anumby-source/RobotServiceJeunesse2022/README.md

# RobotServiceJeunesse2022

Construisez votre voiture robot ! A partir d'un [kit de montage](https://github.com/anumby-source/RobotServiceJeunesse2022/wiki), vous assemblez une voiture intelligente

Vous construisez une voiture-robot avec des cellules solaires ou un détecteur à ultrason. Nous vous aidons à réaliser vos projets

voiture avec guidage par ultrason

[ultrason pour le châssis voiture](
https://user-images.githubusercontent.com/90700891/155990377-5c4f1362-04a4-40f6-9944-eb9b7a41df36.mp4 "ultrason pour le châssis voiture")

voiture avec 2 cellules orientées vers la route ou vers l'avant pour suivre un rayon de soleil

voiturevoiture

Nous avons aussi un peu de travail de bois

bois

Voir le projet complet sur [developpement-voiture](https://github.com/anumby-source/developpement-voiture/wiki)
