anumby-source/RobotServiceJeunesse2022/code/README.md

- [installation de MicroPython sur ESPxxx](https://www.aranacorp.com/fr/programmez-un-esp8266-avec-micropython/)
- [MicroPython for ESP8266 Reference](https://docs.micropython.org/en/latest/esp32/quickref.html)
- [Web server pour ESP8266 en MicroPython](https://randomnerdtutorials.com/esp32-esp8266-micropython-web-server/)



- [micropython async tuto](https://github.com/peterhinch/micropython-async/blob/master/v3/docs/TUTORIAL.md)

- https://micropython.org/download/esp8266/
- https://github.com/anumby-source/developpement-voiture/wiki/d%C3%A9veloppement-IA-en-python#wiki-pages-box
- https://docs.micropython.org/en/latest/esp8266/quickref.html#networking
- https://circuits4you.com/2017/12/21/esp8266-pwm-example/
- https://randomnerdtutorials.com/esp8266-pinout-reference-gpios/

https://dl.espressif.com/dl/package_esp32_index.json,http://arduino.esp8266.com/stable/package_esp8266com_index.json

echo D6
trigger D7
capteur optique:
A0
équilibre 3.3v/2.
