anumby-source/RobotServiceJeunesse2022/Détecteur de collisions/neo/READ-ME.md

capteur ultrason avec LED multicolore

Le capteur ultrason va allumer une led multicolore

- Rouge si distance < 10 cm
- Verte  si distance > 40 cm
- la couleur va changer du jaune, blanc au bleu pour les positions intermédiaires

Pour cela, la PIN D-IN de la LED est placée sur l'entrée TRIGGER du capteur ultrason

L'écriture de la LED est effectuée une fois la lecture du capteur ultrason. Un délai est ajouté pour tenir compte de la distance maximale de détection
