anumby-source/RobotServiceJeunesse2022/MotorShield.docx

MotorShield

Technical specs

https://cdn.hackaday.io/files/8856378895104/user-mannual-for-esp-12e-motor-shield.pdf

Schema

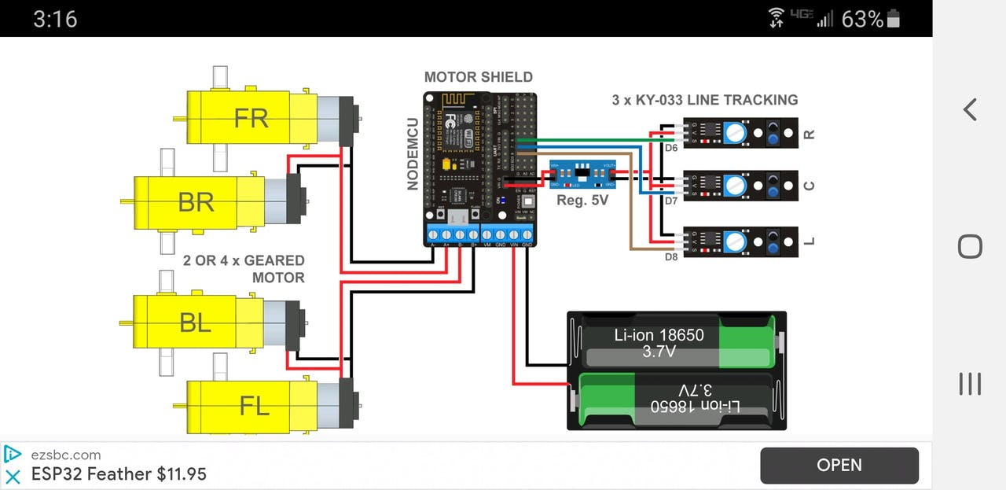
[picture p1: figure]
What Do I Build Next? ESP8266MOD WiFi car - Hackster.io
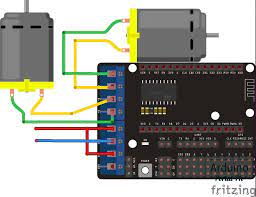
[picture p2: figure]
NodeMcu Motor Shield. Описание и тестовый Скетч
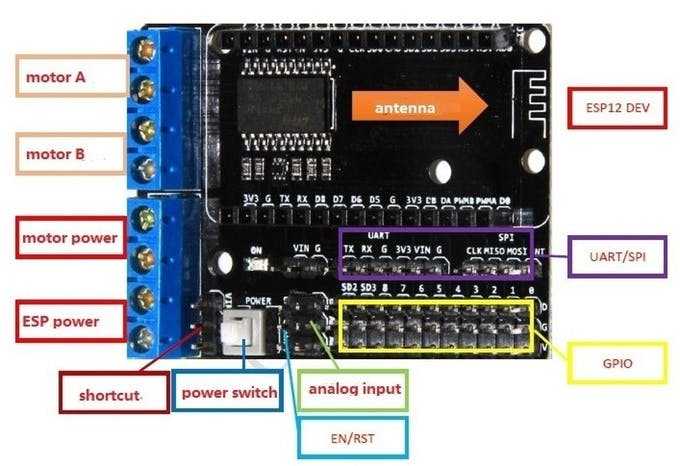
[picture p3: figure]
ESP Motorshield
