anumby-source/RobotServiceJeunesse2022/code/robot/doc.pptx

## Code pour le robot

Robot.ino

## Slide 2

Motorisation

Moteur
droit

D1

D3

Moteur
gauche

D2

D4

PWM

Motorisation

Stop()
Avance()
Recule()
Droite()
Gauche()
Action(commande)

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
Direction
DROIT
DROITE
GAUCHE

Commande D/G ()
Vitesse, Sens

Action(commande)

Boîte de Vitesse()

Sens
STOP
AVANCE
RECULE

## Slide 3

Ultrason

Lecture()

obstacle

AVANCE

< seuil2

DROIT

0

RECULE

< seuil1

direction

Avance()

GAUCHE

DROITE

M.gauche()

Choix Random()

GAUCHE

M.gauche()

DROITE

M.droite()

M.droite()

commande

Motorisation

Action(commande)

> seuil1

Ultrason

D7

D6

Trigger

echo

UltraSon

Lecture()
Action(commande)

seuil1
seuil2

légende

Si…

retour

variable

## Slide 4

Web

handle_args()

O.action(commande)

Web_Suivi

Pager()

server.argName

server.args()

Web

Init()
Header()
Trailer()
virtual Pager()
Int id

Web_Motorisation

Pager()

comande = server.arg

COMMANDE

MANUEL

COLLISION

EQUILIBRAGE

Web_Collision

Pager()

M.action(commande)

WM.pager()

SUIVI

Web_Equilibrage

Pager()

U.action(commande)

WC.pager()

légende

Si…

retour

variable

WS.pager()

WB.pager()

O.equilibrage(commande)
