anumby-source/RobotServiceJeunesse2022/Base/README.md

Documents pour la base
=======================
