anumby-source/RobotServiceJeunesse2022/Détecteur de collisions/README.md

Documents pour le détecteur de collisions
=========================================
