anumby-source/RobotServiceJeunesse2022/Plan d'actions.md

Préparation du [projet "Robot Service Jeunesse"](https://github.com/anumby-source/RobotServiceJeunesse2022/blob/main/Administration/2022%2003%2009%20Service%20Jeunesse%20V%C3%A9hicule%20WIFI%20pilot%C3%A9%20par%20s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) en prévision de la journée du 6 mai 2022
=======================================================================================

- Les documents du projet précédent 2019 ont été récupérés et instalés dans le dossier [Documents 2019](https://github.com/anumby-source/RobotServiceJeunesse2022/tree/main/Documents%202019)
- vérifier la liste des composants 
    -	Une boîte en plastique
    -	Socle
    -	2 roues
    -	Esp + barrettes 
    -	Shield
    -	Entretoises
    -	piles
    -	Sachet avec 
        -	le support pour les piles
        -	les moteurs
        -	la roulette avant
        -	visserie
- vérifier le mode opératoire
- le mardi 15 mars on réalise un montage de test pour vérifier
    - les éléments
    - le mode opératoire
    - le plan de cablage 
- quelques notes:
    - enlever la pellicule de protection
    - ajuster les trous sur la plaquette et ajouter les entretoises pour écarter le shield
    - comprendre le programme -> produire l’organigramme
    - préparer des options pour ajouter des capteurs
        - suiveurs de ligne
        - détection des obstacles (ultrason)
    - téléverser les programmes dans les esp

Principes de fonctionnement pour le projet:
===========================================

A priori tout ce que l'on prépare (le robot, sa base et ses options ultérieures) ont vocation à être réalisées par des jeunes du ServiceJeunesse, soit lors de la journée du 6 mai 2022, ou bien ultérieurement lors de futures sessions accompagnées par Anumby. Donc l'idée est que tout ce que l'on propose doit être "faisable", c'est à dire:
- documenté
- associé - sous forme de document ou d'un lien - à:
    - la liste des composants nécessaires 
    - le mode opératoire
    - les programmes à flasher
    - les plans de câblage
 - si ces éléments ne sont pas disponible, ceci doit être consigné dans une "action" (autrement dit une "issue") qui sera fermée lorsque l'element sera fourni
