anumby-source/RobotServiceJeunesse2022/Documents 2019/Tutoriel Véhicule WIFI piloté par smartphone V2.odp

## Tutoriel Mini véhicule WIFI piloté par smartphone

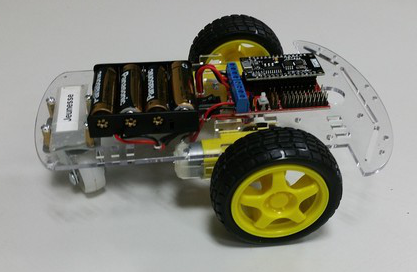
[picture p25: figure]

Sommaire

  Liste des pièces détachées
1. Fixation de la roue arrière pivotante
2. Montage moteurs
3. Montage roues motrices
4. Montage boîtier de piles
5. Montage shield moteur
6. Branchement boîtier de piles
7. Branchement moteurs droit et gauche
8. Fixation du microcontroleur
1. Insertion des piles et mise en service
1. Recherche du réseau WIFI du vhicule
2. Entrée du mot de passe
3. Lancer le navigateur de son smartphone
4. Saisie de l’adresse IP

Matériel prêté par l’Anumby

- Tournevis
- Pince
- Huile (pour la roue pivotante)

Apporter son smartphone

## Pièces détachées

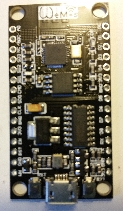
[picture p26: figure]

Le coeur du véhicule.

Programme et serveur WIFI

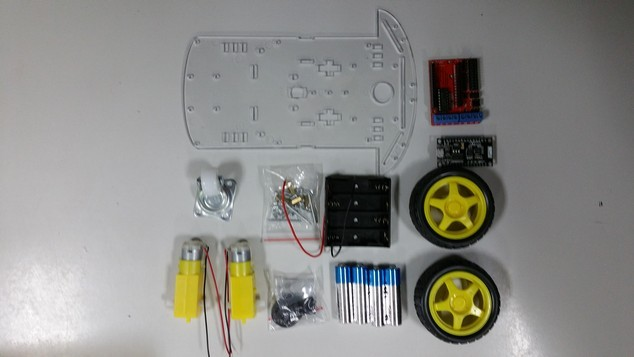
[picture p27: figure]

Châssis

ESP 8266 12 E

Roue arrière pivotante

Shield moteur

2 moteurs, (fils soudés)

Vis,

entretoises

4 piles AA

Porte piles

2 Roues motrices

## Fixation de la roue avant pivotante

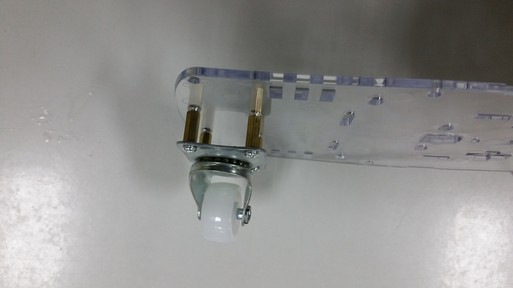
[picture p28: figure]
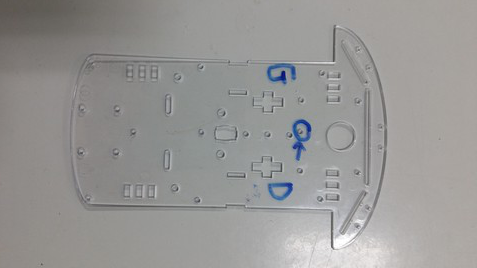
[picture p29: figure]
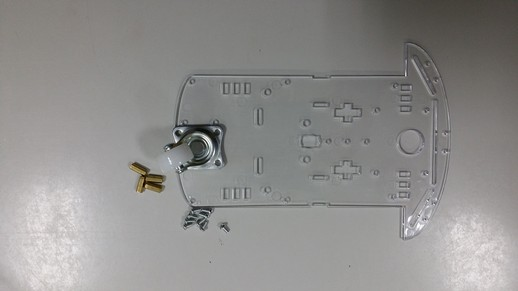
[picture p30: figure]

4 Entretoises

8 Vis

Roulette pivotante

Attention !

Placer la roue pivotante sous le châssis avec un trou décalé vers le coté gauche du châssis.

## 2) Montage des moteurs

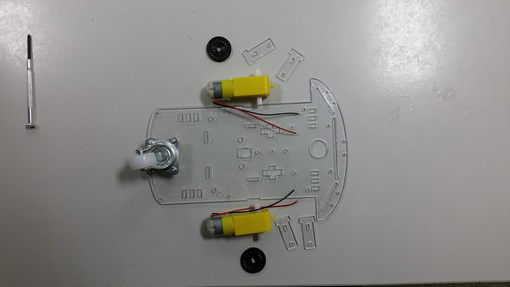
[picture p31: figure]
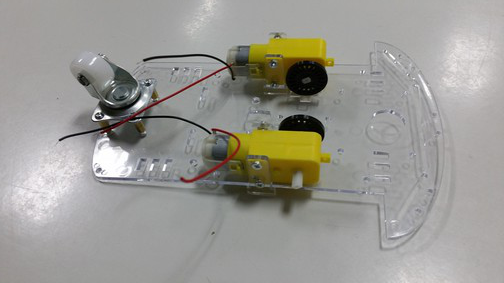
[picture p32: figure]
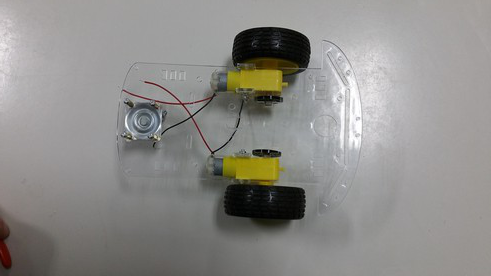
[picture p33: figure]
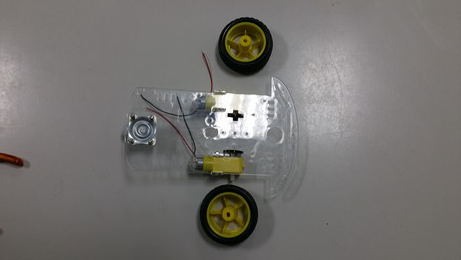
[picture p34: figure]

3) Montage des roues motrices

## 4) Montage boîtier de piles

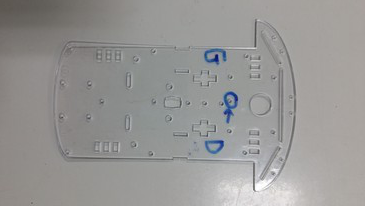
[picture p35: figure]
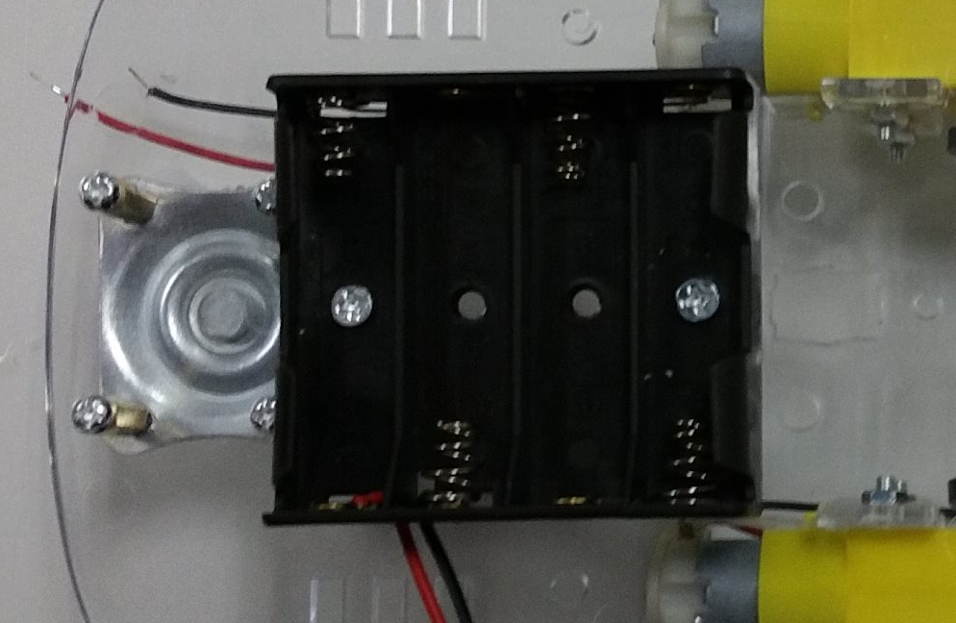
[picture p36: figure]

2 vis et écrous

5) Montage du shield (extension en français) moteur (électronique de commande des moteurs et pont en H permettant l’inversion de sens de rotation des moteurs)

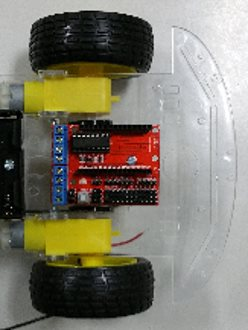
[picture p37: figure]

1 vis + écrou + entretoise

Arrière du véhicule

Avant du véhicule

Rappel !

Vérifier que, vu de dessus, le trou décalé du châssis se situe vers le moteur gauche !

Moteur Gauche

## 6) Branchement du boîtier de piles

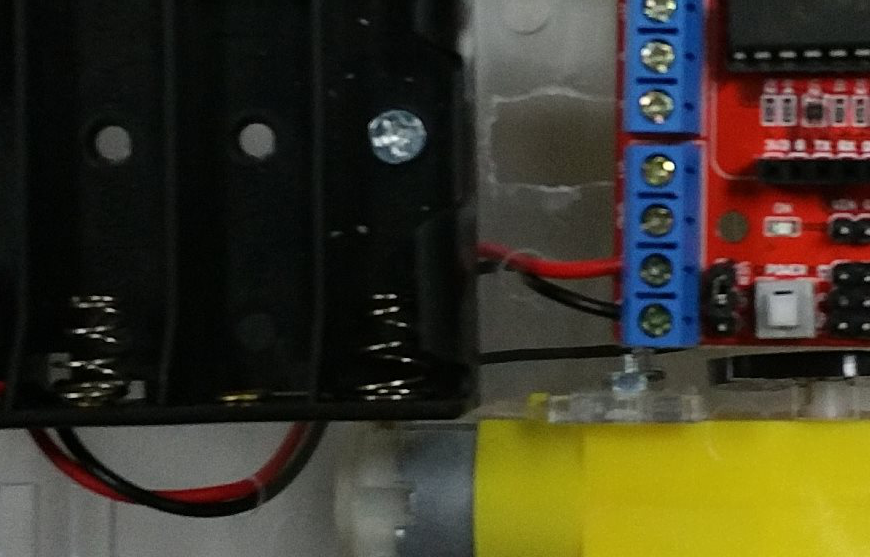
[picture p38: figure]

Branchement du câble + et du fil - sur le bornier

7) Branchement moteurs gauche et droite

Moteur gauche

câbles + et – sur le bornier (partie gauche)

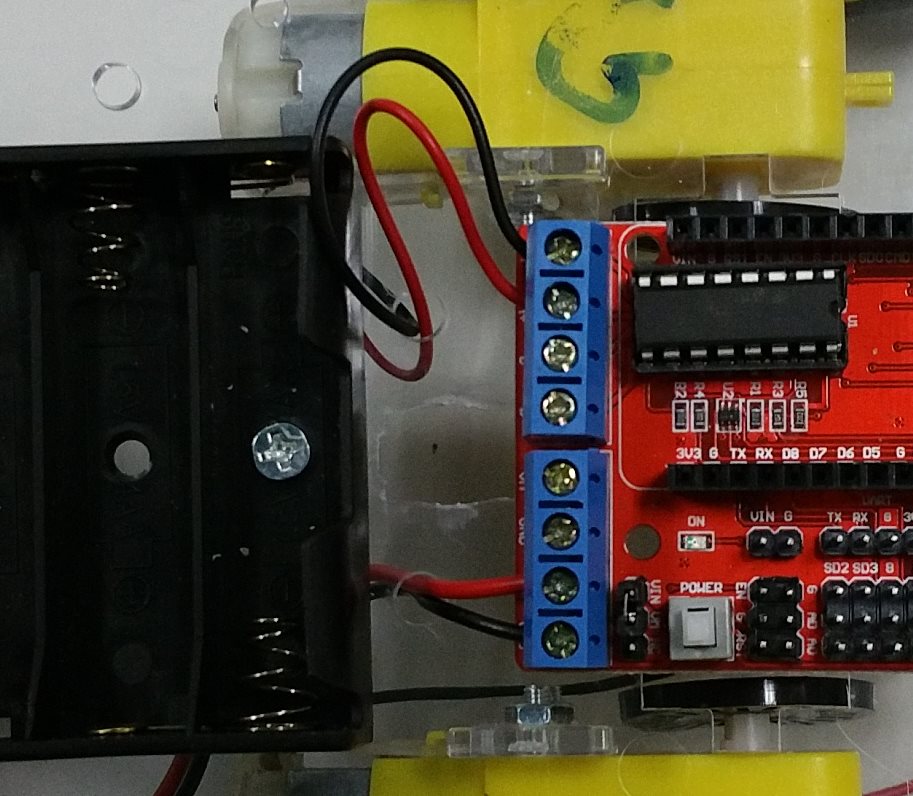
[picture p39: figure]

Moteur droite

Câbles + et – sur le bornier (partie droite)

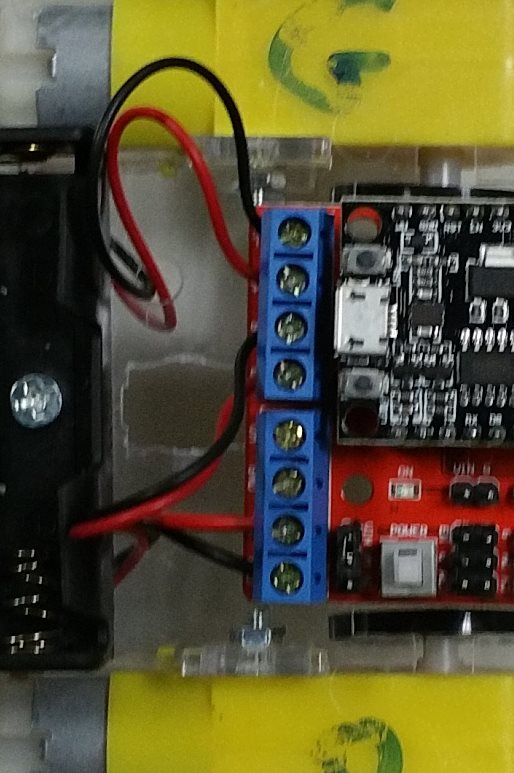
[picture p40: figure]

## 8) Fixation du microcontroleur ESP 8266 sur le shield moteur

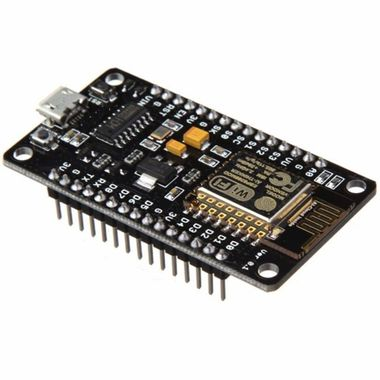
[picture p41: figure]

Antenne WIFI

Attention au sens du montage !

Antenne WIFI de l’ESP 8266 vers l’arrière du véhicule

Arrière du véhicule

## 9) Insertion des piles et mise en service

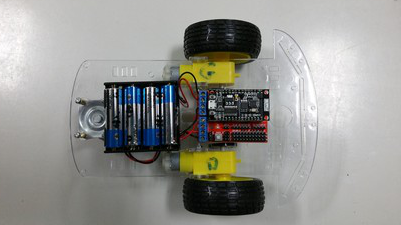
[picture p42: figure]
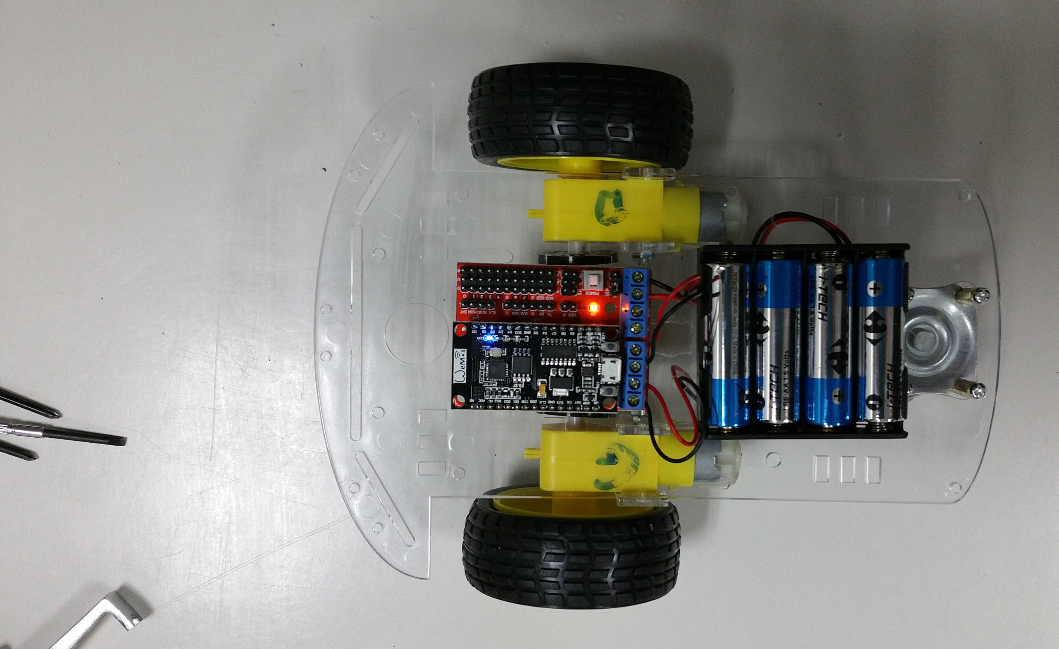
[picture p43: figure]

Vérifier le sens des piles !

Appuyer sur l’interrupteur du shield

Une led rouge s’allume

Le véhicule est prêt à être piloté !

## 10) Recherche du réseau WIFI de votre véhicule

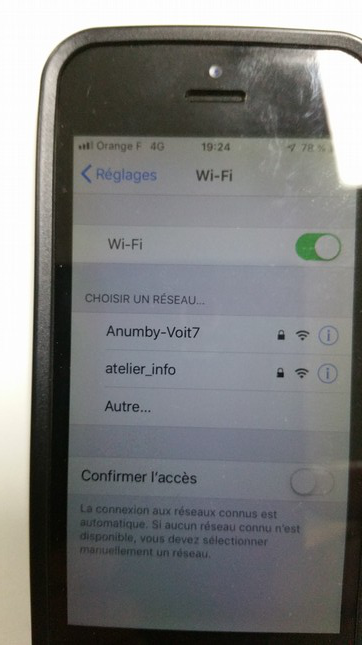
[picture p44: figure]

Avec la plupart des smartphones

1. Paramètres/
2. Connexion réseau/
3. WIFI/
4. Chercher le réseau Anumby-Voiture- -
5. Taper sur connexion

11) Taper le mot de passe : 12345678

## 12) Lancer le navigateur de son smartphone

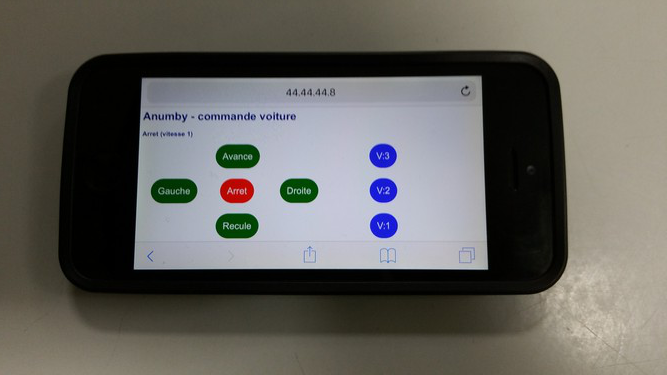
[picture p45: figure]

13) Taper l’adresse IP : 44.44.44.1 à 6

(Chaque véhicule est numéroté de 1 à 6)

Puis Piloter son véhicule
