anumby-source/RobotServiceJeunesse2022/Documents 2019/Organigramme Programme Voiture.pdf

# ANUMBY Organigramme Programme Voiture

## 8 Mars 2019

# Programme Principal

Inclusion librairies:
- WiFi
- WebServer
- Mise à jour à distance

Définition Variables:
- Nom WiFi
- Mot de passe
- Adresse IP
- Vitesses moteurs

Setup – Initialisations:
WiFi
Fonctions mise à jour
Commandes voitures
Erreur affichage Page Web

Loop:
Action si mise à jour
programme demandée à
distance
Affichage Page Web

# Programme dans la Loop

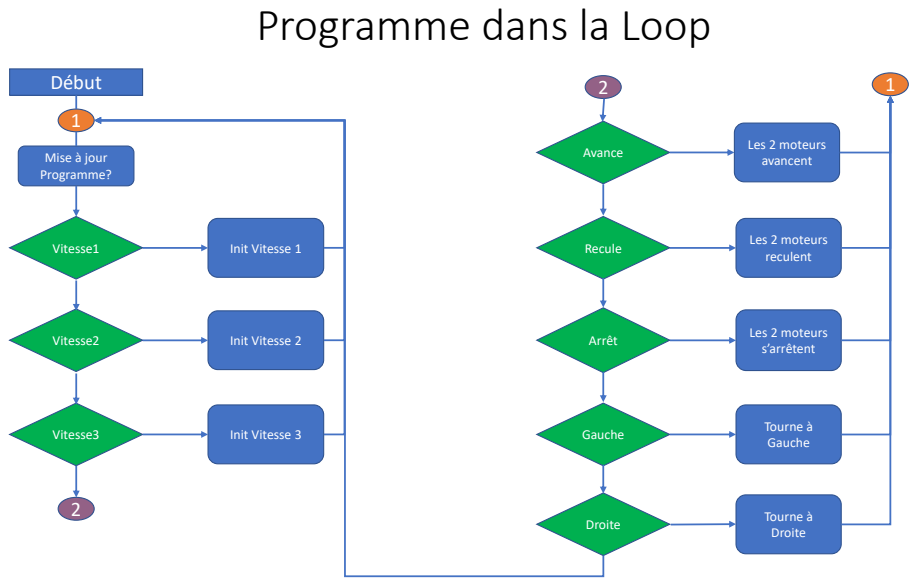
[picture p49: page 3]
Début; Vitesse1; Init Vitesse 1; Vitesse2; Init Vitesse 2; Vitesse3; Init Vitesse 3; Avance; Les 2 moteurs; avancent; Recule; reculent; Arrêt; s’arrêtent; Gauche; Tourne à; Droite; Mise à jour Programme?
