anumby-source/RobotServiceJeunesse2022/bures.png

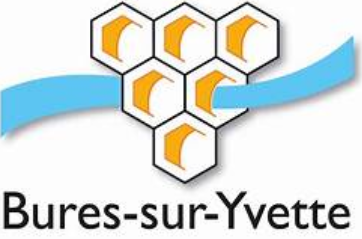
bures.png
