anumby-source/RobotServiceJeunesse2022/code/CapteurPhotoSensible/CPS.bmp

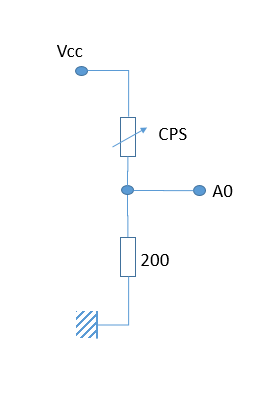
code/CapteurPhotoSensible/CPS.bmp
