anumby-source/RobotServiceJeunesse2022/code/robot/cps_ultrason.jpg

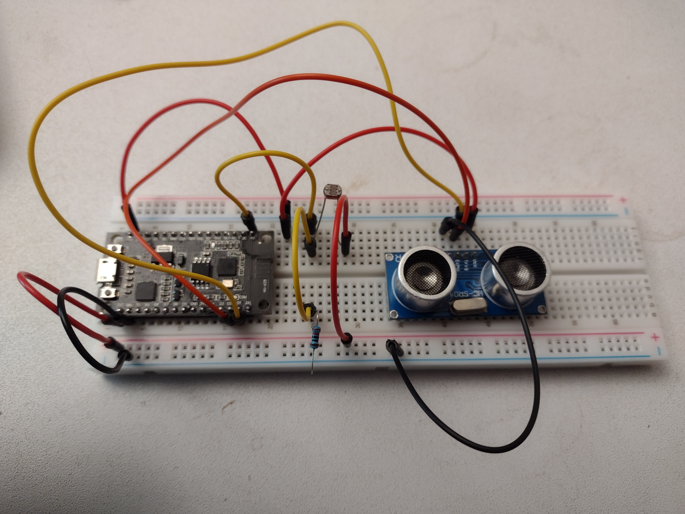
code/robot/cps_ultrason.jpg
