anumby-source/RobotServiceJeunesse2022/connecteur-solaire.png

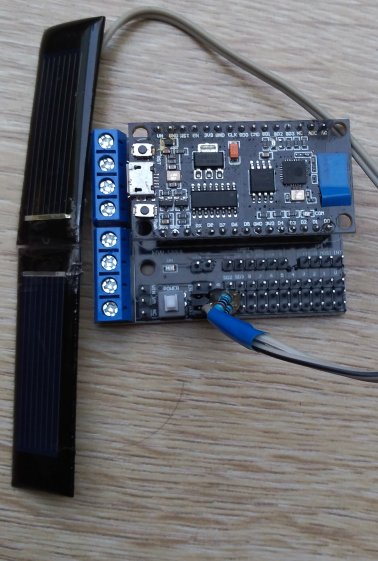
connecteur-solaire.png
