anumby-source/RobotServiceJeunesse2022/connecteur-ultrason.png

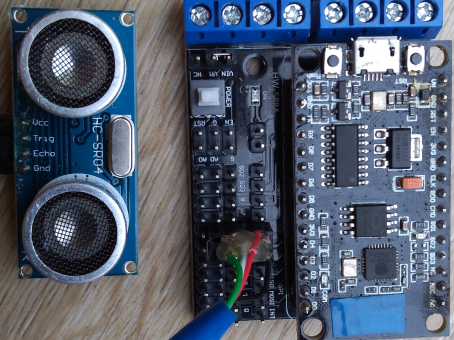
connecteur-ultrason.png
