anumby-source/RobotServiceJeunesse2022/connecteur.png

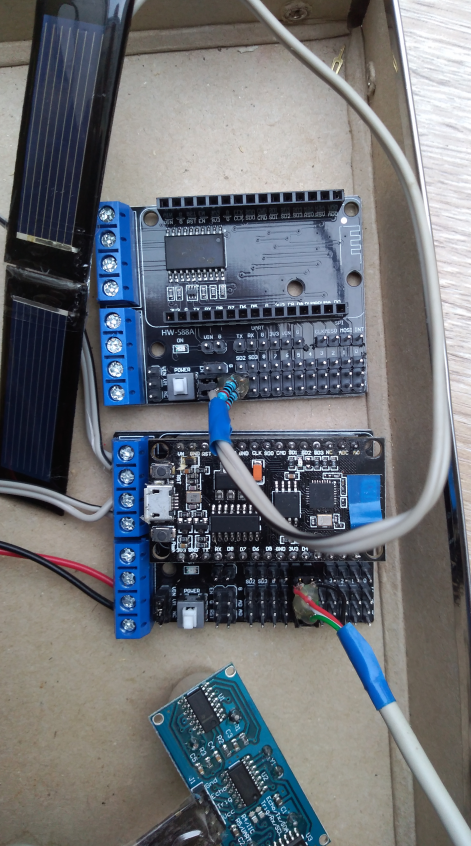
connecteur.png
