anumby-source/RobotServiceJeunesse2022/Détecteur de collisions/neo.png

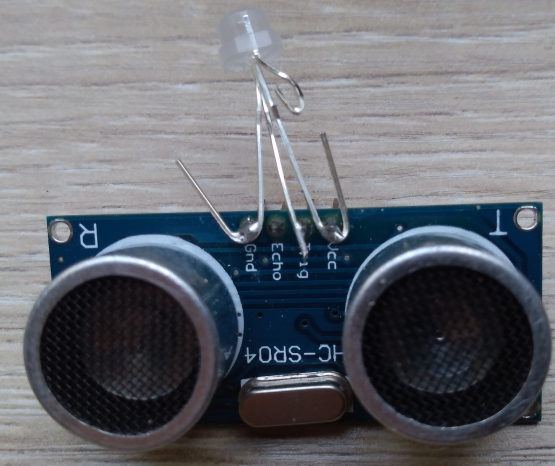
Détecteur de collisions/neo.png
