anumby-source/RobotServiceJeunesse2022/robot-soleil.png

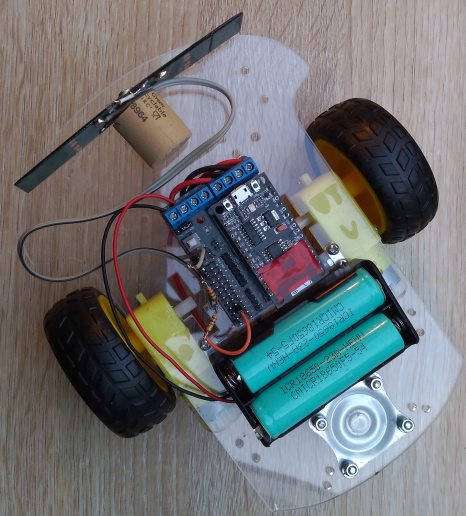
robot-soleil.png
