anumby-source/RobotServiceJeunesse2022/Base/Nomen_Véhi.ods

 |  |  | Nomenclature Véhicule robotisé
Rep, | Désignation | Référence | fabricant | Fournisseur | Quté | Prix | Commentaires
 | Plaque chassis |  |  |  | 1
 | Roue folle |  |  |  | 1
 | Roue codeuse |  |  |  | 2
 | carte processeur | WIFI-ESP8266 / USB-TTCH340 / Vin5-9U | Arduino |  | 1
 | carte interface 2 moteurs CC ou 1 moteur pas à pas : | ESP 12 E motor shield | Arduino |  | 1
 | Roues motrices |  |  |  | 2
 | Moto-réducteur |  |  |  | 2
 | Porte piles |  |  |  | 1
 | Plles AA |  |  |  | 4
 | Interupteur M/A |  |  |  | 1
 | Kit éléments de fixation |  |  |  | 1 |  | comprend visserie, entretoise, équerres fixation moto-réducteur
 | capteur ultrason |  |  |  | 1
 | support du capteur ultrason |  |  |  | 1
 | kit interco |  |  |  | 1 |  | câbles
 | Autres éléments à prévoir : | fils pour le câblage
 | Outillage à prévoir : | tournevis droit et cruciforme ( le doit être équipé de son téléphone WIFI )
