anumby-source/RobotServiceJeunesse2022/Administration/2022 03 09 Devis animation service jeunesse V1.xlsx

ANUMBY
L'Atelier Numérique de Bures sur Yvette | L'Atelier Numérique de Bures sur Yvette
Adresse : 45, rue du Général de Gaulle |  |  |  | contact@anumby.org
91440 Bures sur Yvette |  |  |  | Site web : https://www.anumby.org
N° Devis : 2022/001 |  | Destinataire :
 |  | Mairie de Bures sur Yvette - Service Jeunesse
Date devis : 09/03/2022 |  | Adresse : 45, rue Charles de Gaulle
 |  | 91440 Bures sur Yvette
Animation 1/2 journée (3h) durant les vacances de printemps pour le service Jeunesse - 6 stagiaires
Vendredi 6 mai 2022 de 14h à 17h
Date | Description | Qté | Prix unitaire | Remise | Prix
2019-02-08 | Initiation à la robotique | 6 | 16.67 € |  | 100.00 €
 | Fabrication d'un véhicule électrique piloté par smartphone, avec capteurs d'évitement d'obstacle et de suivi de ligne |  |  |  | 0.00€
 |  |  |  |  | 0.00€
 |  |  |  |  | 0.00€
 |  |  |  |  | 0.00€
 |  |  |  |  | 0.00€
 |  |  |  |  | 0.00€
 |  |  |  |  | 0.00€
 |  |  |  |  | 0.00€
 |  |  |  |  | 0.00€
 |  |  |  |  | 0.00€
 |  |  |  |  | 0.00€
 |  |  |  | Sous-total | 100.00 €
Les chèques doivent être libellés à l’ordre de ANUMBY. |  |  |  | Autres
Association exonérée des impôts commerciaux. TVA non applicable article 293 B du CGI. |  |  |  | Acompte reçu
Association Loi 1901, déclarée à la sous-préfecture de Palaiseau. Identification R.N.A. : W913007589. |  |  |  | TOTAL | 100.00 €
