anumby-source/RobotServiceJeunesse2022/code/auto-test-multicouleur/READ-ME.md

# Introduction

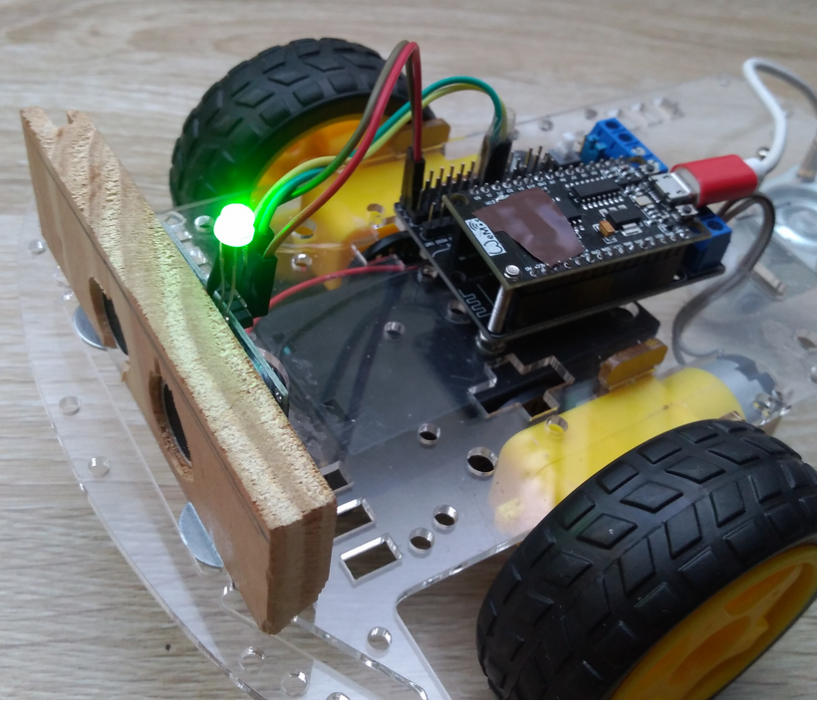
[picture p58: Détecteur de collisions/neo-robot.png]
neo-robot


Ce projet est une adapatation de la voiture 2 roues Anumby 2021 multi-capteur avec LED multicolore

pas besoin de pin pour la LED : la PIN D-IN de la LED est placée directement sur l'entrée TRIGGER du capteur ultrason

AUTO TEST

bip moteur

AUTO TEST ULTRA SON seul 

allumage de la LED neopixel sans moteur

Le capteur ultrason va allumer une led multicolore sans moteur

le moteur ne se met en route que lorsque la distance est < 10 cm

AUTO TEST OPTIQUE seul 

allume une led pour optique sans moteur

- Rouge pour la droite
- Verte tout droit si la balance est à l'équilibre
- Bleu  pour la gauche

- la couleur va changer du rouge, vert au bleu continûment  pour les positions intermédiaires

# Liste de materiel:
- __ESP8266 Nodemcu__ : https://fr.aliexpress.com/item/32659028315.html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
- __shield moteur L293D__ : https://fr.aliexpress.com/item/1005003186128473.html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
- __capteur ultrason HC-SR04__
- __diode neopixel ws2811__
- __2 cellules photovoltaïques__ : https://fr.aliexpress.com/item/32814941048.htm
- __2 résistances__

# Schema electrique
