anumby-source/RobotServiceJeunesse2022/code/auto-test-ultrason/READ-ME.md

1 bip : moteur
2 bip : capteur optique branché
3 bip : capteur optique à l'équilibre

si pas d'obstacle on avance
si la distance ultrason est inférieure à seuil1 : on contourne l'obstacle
si la distance ultrason est inférieure à seuil2 : passage en manuel

  const int seuil1 = 40;  // si on est > seuil1 on avance, si non on tourne à droite
  const int seuil2 = 10;  // si on est < seuil2 on stop car on n'a plus la place de tourner
