anumby-source/RobotServiceJeunesse2022/(threads)

Thread 3 (2022-04-05):

Acheter des cosses pour l'interruteur

ChrisArnault, 2022-04-05:
Il faudrait acheter des cosses pour les broches de l'interrupteur du robot (2 x 10)

taille: 5,5 mm

@pierreleop
@condorpasa
@Philippe9175
@arnaudrco

ChrisArnault, 2022-04-05:
Référence sur Amazon

https://www.amazon.fr/connecteurs-sertir-fourche-%C3%A9lectriques-isol%C3%A9s/dp/B081PRKZXK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

@pierreleop
@Condorpasa
@Philippe9175
@arnaudrco

Thread 6 (2022-04-05):

Préparer la câbles d'alimentation

ChrisArnault, 2022-04-05:
Prévoir les longueurs de câbles
- une longueur entre les piles et l'interrupteur
- une longueur entre l'interrupteur et le bornier

@pierreleop
@Condorpasa
@Philippe9175
@arnaudrco

Thread 8 (2022-04-05):

Faire évoluer la partie de programme serveur Web

ChrisArnault, 2022-04-05:
Le programme d'origine
+ ajouter des boutons de pilotage des modes opératoires
+ mode commande par le smartphone
+ mode détection d'obstacle
+ mode suivi de la route / suivi d'une lampe

@pierreleop
@Condorpasa
@Philippe9175
@arnaudrco
