anumby-source/RobotServiceJeunesse2022/code/robot/doc.pdf

# Code pour le robot

## Robot.ino

### Motorisation

### Moteur

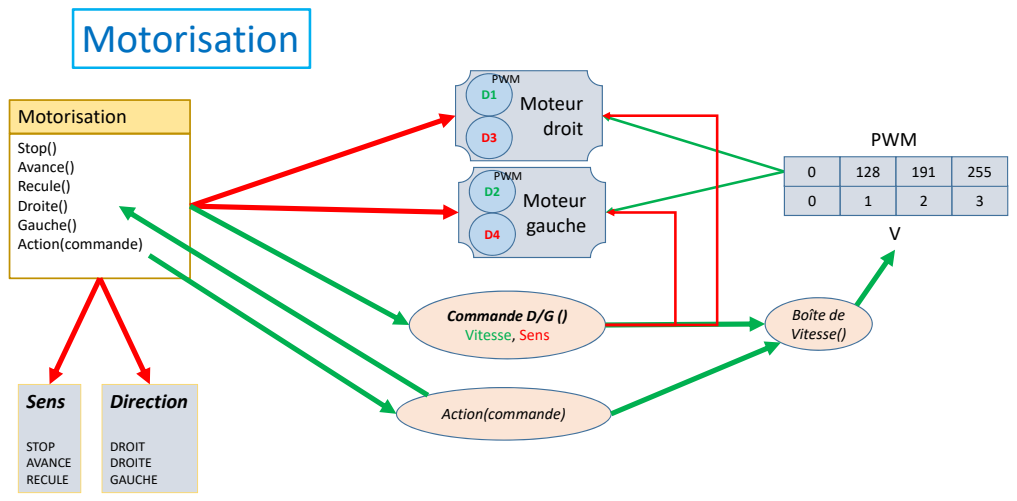
[picture p59: page 2]
Stop() Avance() Recule() Droite() Gauche() Action(commande); droit; Moteur gauche; Boîte de Vitesse(); Commande D/G () Vitesse, Sens; PWM; Direction; DROIT DROITE GAUCHE; Sens; STOP AVANCE RECULE; Action(commande); Motorisation

0 | 128 | 191 | 255

### Motorisation

# Ultrason

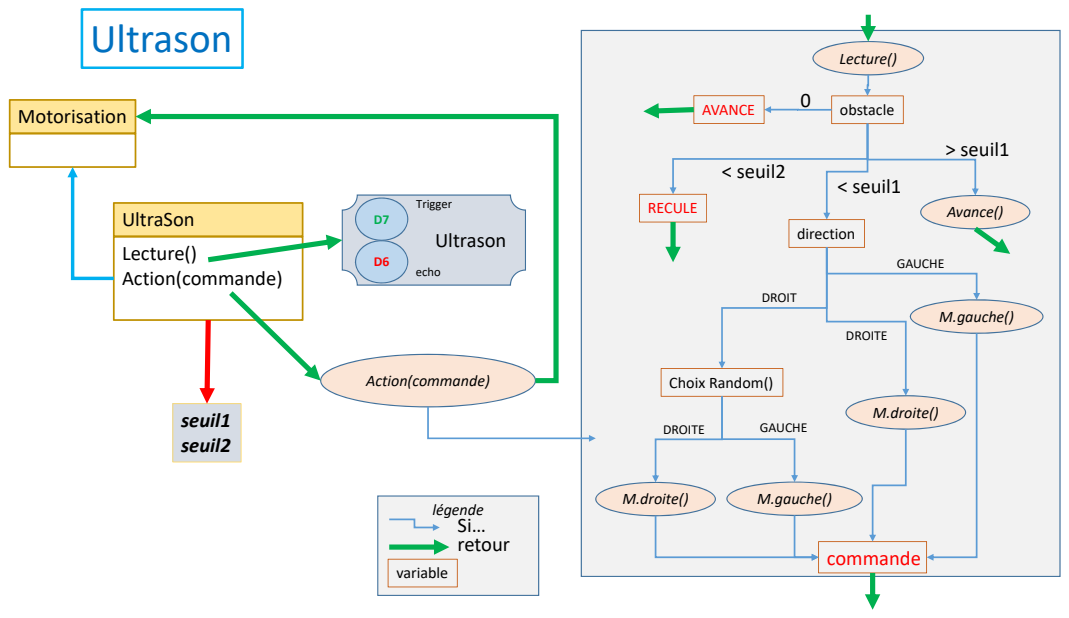
[picture p60: page 3]
légende; UltraSon; Lecture() Action(commande); Ultrason; Trigger; echo; seuil1 seuil2; Action(commande); obstacle; Lecture(); AVANCE; < seuil1 < seuil2; RECULE; direction; Avance(); DROIT; DROITE; GAUCHE; Choix Random(); M.droite(); M.gauche(); commande; > seuil1; Si… retour; variable

### Web_Suivi

### handle_args()

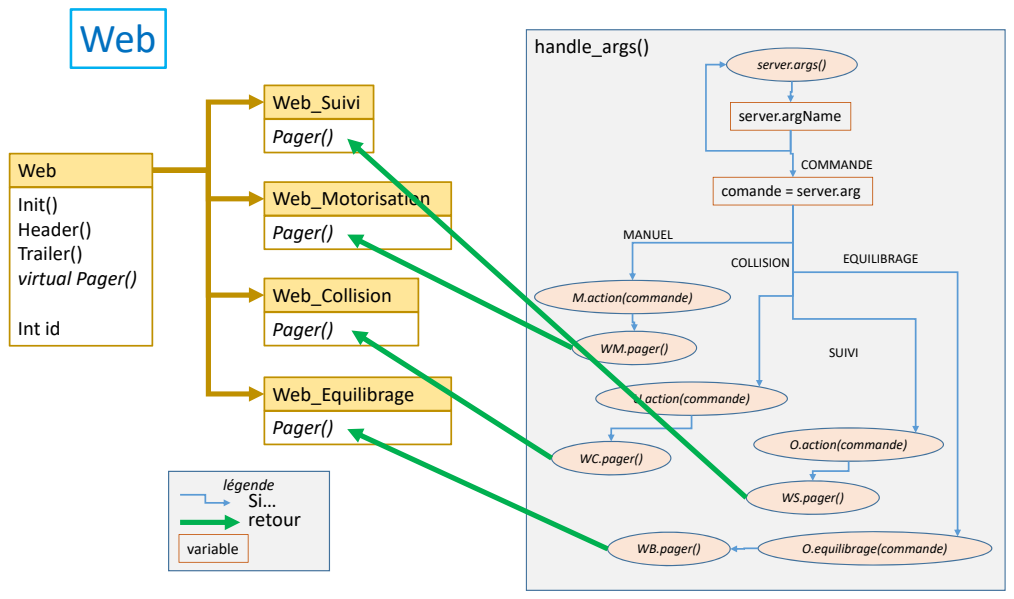
[picture p61: page 4]
Web; Init() Header() Trailer() virtual Pager(); Int id; Web_Motorisation; Pager(); Web_Collision; Web_Equilibrage; server.args(); légende Si… retour; variable; server.argName; COMMANDE; MANUEL; COLLISION; SUIVI; EQUILIBRAGE; M.action(commande); U.action(commande); O.action(commande); O.equilibrage(commande); WM.pager(); WC.pager(); WS.pager(); WB.pager()

comande = server.arg
