anumby-source/RobotServiceJeunesse2022/code/auto-test-multicouleur/auto-test-multicouleur.ino

//
// Code auto test des capteurs pour le Robot pour l'événement Service Jeunesse 2022
//
// le coeur du code est hérité du code développé par Arnaud
// Reformatté et structuré pour l'algorithmique en C++ par Chris
// A REICHART allume une led pour optique
// The colours are a transition r - g - b
// allume une led pour ultrason si pas d'optique
// Rouge si distance < 10 cm
// Verte  si distance > 40 cm
// PIN D-IN placée sur entrée TRIGGER du capteur ultrason

#include <Adafruit_NeoPixel.h>
#ifdef __AVR__
  #include <avr/power.h>
#endif

// Which pin on the Arduino is connected to the NeoPixels?
// On a Trinket or Gemma we suggest changing this to 1
#define PIN            D6

// How many NeoPixels are attached to the Arduino?
#define NUMPIXELS      1

// When we setup the NeoPixel library, we tell it how many pixels, and which pin to use to send signals.
// Note that for older NeoPixel strips you might need to change the third parameter--see the strandtest
// example for more information on possible values.
Adafruit_NeoPixel pixels = Adafruit_NeoPixel(NUMPIXELS, PIN, NEO_GRB + NEO_KHZ800);

#include <ESP8266WiFi.h>
#include <DNSServer.h>
#include <ESP8266WebServer.h>

#define STOP    1
#define AVANCE  2
#define RECULE  3
#define DROITE  4
#define GAUCHE  5
#define LENT    6
#define RAPIDE  7
#define SENSMIN 8
#define SENSMAX 9

#define MANUEL    10
#define COLLISION 11
#define SUIVI     12
#define BALANCE   13

//                  0   1               2      3                  4         5        6    7   8
String dirs[9] = { "", "Arr&ecirc;t", "Avant", "Arri&egrave;re", "Droite", "Gauche", "", "", ""};

WiFiServer server(80);

class Robot {
  public:
    int initial ; // valeur initiale du capteur balance lumière
    int valeur;
    int sensibilite ; // sensibilité
    int commande = 0;
    int dir = STOP;

    void set_commande(int commande){
      this->commande = commande;
      if (commande == STOP || commande == AVANCE || commande == RECULE || commande == DROITE || commande == GAUCHE) this->dir = commande;
      };

    int direction(){
      return (this->dir);
    };
};

class Web {
  public:
    void init(Robot* robot);
    void web_page(WiFiClient client, int commande);
    WiFiClient client();
    int action();
  private:
    Robot* robot = NULL;
};

WiFiClient Web::client()
{
   return (server.available());
}

void Web::init(Robot* robot)
{
    this->robot = robot;

    IPAddress apIP(44, 44, 44, 44);         // Définition de l'adresse IP statique.
    const char *password = "12345678";      // mot de passe (*** A modifier ***)
    char ssid[30];
    sprintf(ssid, "RCO_%d", ESP.getChipId()); // ceci différencie la connexion pour chaque voiture

    // declaration du wifi:
    WiFi.mode(WIFI_AP);
    WiFi.softAPConfig(apIP, apIP, IPAddress(255, 255, 255, 0));
    WiFi.softAP(ssid, password);

    // if you get here you have connected to the WiFi
    Serial.println("Connected.");

    server.begin();
}

void Web::web_page(WiFiClient client, int commande)
{
    String html = String("<!DOCTYPE html> \
<html> \
<head> \
<style> \
  .echo {width: 50px;} \
  .cmd { padding:10px 10px 10px 10px; \
            margin:10px; \
            width:100%;  \
            background-color: red; \
            font-size: 250%;\
            color:white;} \
  .param { margin:10px; \
            width:100%;  \
            background-color: yellow; \
            font-size: 150%;\
            color:blue;} \
  .button { padding:10px 10px 10px 10px; \
            margin:10px; \
            width:100%;  \
            background-color: green; \
            font-size: 250%; \
            color:white;} \
</style> \
<center><h1>Robot Service Jeunesse \
</h1> \
  <form> \
      <label for='commande'>commande:</label> \
      <input class='echo' id='commande' name='commande'  value='") + commande +
String("'> \
      <label for='direction'>direction:</label> \
      <input class='echo' id='direction' name='direction'  value=' ") + dirs[this->robot->direction()] +
String("'> \
      <table> \
          <tr> \
              <td> <button name='LED0' class='cmd' value='") + String(MANUEL) + String("' type='submit'> Manuel </button></td> \
              <td> <button name='LED0' class='cmd' value='") + String(COLLISION) + String("' type='submit'> Collision </button></td> \
              <td> <button name='LED0' class='cmd' value='") + String(SUIVI) + String("' type='submit'> Suiveur </button></td> \
              <td> <button name='LED0' class='cmd' value='") + String(BALANCE) + String("' type='submit'> Blancs </button></td> \
          </tr> \
      </table> \
  </form> \
  <form> \
      <TABLE> \
          <TR> \
              <TD> <p class='param'> Sensibilit&eacute; </p></TD> \
              <TD> <button name='LED0' class='param' value='") + String(SENSMIN) + String("' type='submit'> << </button></TD> \
              <TD> <button name='LED0' class='param' value='") + String(SENSMAX) + String("' type='submit'> >> </button></TD> \
          </TR> \
          <TR> \
              <TD> <p class='param'> Vitesse </p></TD> \
              <TD> <button name='LED0' class='param' value='") + String(LENT) + String("' type='submit'> Lent </button></TD> \
              <TD> <button name='LED0' class='param' value='") + String(RAPIDE) + String("' type='submit'> Rapide </button></TD> \
          </TR> \
          <TR> \
              <TD> </TD> \
              <TD> <button name='LED0' class='button' value='") + String(AVANCE) + String("' type='submit'> Avant </button></TD> \
              <TD> </TD> \
          </TR> \
          <TR> \
              <TD> <button name='LED0' class='button' value='") + String(GAUCHE) + String("' type='submit'> Gauche </button></TD> \
              <TD> <button name='LED0' class='button' value='") + String(STOP) + String("' type='submit'> Stop </button></TD> \
              <TD> <button name='LED0' class='button' value='") + String(DROITE) + String("' type='submit'> Droite </button></TD> \
          </TR>\
          <TR> \
              <TD> </TD> \
              <TD> <button name='LED0' class='button' value='") + String(RECULE) + String("' type='submit'> Arri&egrave;re </button></TD> \
              <TD> </TD> \
          </TR>\
      </TABLE> \
  </form> \
  </center>\
</head> \
</html>");

      client.print(html);
}

int Web::action()
{
  WiFiClient client = this->client();

  if (!client) return (0);
  String request = client.readStringUntil('\r');

  int commande = 0;

  //-----------------COMMANDES------------
  if (request.indexOf("LED0=" + String(MANUEL)) != -1) commande = MANUEL;
  else if (request.indexOf("LED0=" + String(COLLISION)) != -1) commande = COLLISION;
  else if (request.indexOf("LED0=" + String(SUIVI)) != -1) commande = SUIVI;
  else if (request.indexOf("LED0=" + String(BALANCE)) != -1) commande = BALANCE;

  //-----------------PAVE HAUT------------
  else if (request.indexOf("LED0=" + String(SENSMIN)) != -1) commande = SENSMIN;
  else if (request.indexOf("LED0=" + String(AVANCE)) != -1) commande = AVANCE;
  else if (request.indexOf("LED0=" + String(SENSMAX)) != -1) commande = SENSMAX;

  //-----------------PAVE CENTRE------------
  else if (request.indexOf("LED0=" + String(GAUCHE)) != -1) commande = GAUCHE;
  else if (request.indexOf("LED0=" + String(STOP)) != -1) commande = STOP;
  else if (request.indexOf("LED0=" + String(DROITE)) != -1) commande = DROITE;

  //-----------------PAVE BAS------------
  else if (request.indexOf("LED0=" + String(LENT)) != -1) commande = LENT;
  else if (request.indexOf("LED0=" + String(RECULE)) != -1) commande = RECULE;
  else if (request.indexOf("LED0=" + String(RAPIDE)) != -1)  commande = RAPIDE;

  // Serial.print("commande = "
  // Serial.println(commande);

  this->robot->set_commande(commande);

  this->web_page(client, commande);

  request = "";
  return (commande);
};

//-------------------- MOTEUR -------------------------------
class Motorisation{
  private:
     Robot* robot = NULL;
     int pin_droite = 0; // broche enable du L298N pour le premier moteur
     int pin_gauche = 2; //  broche enable du L298N pour le deuxième moteur
     int speed_droite = 4; // Premier moteur
     int speed_gauche = 5; // Deuxième moteur
     int avant = HIGH;
     int arriere = LOW;

  public:
     int vitesse_max = 500;
     int vitesse_min = 200;

  Motorisation(Robot* robot){
    this->robot = robot;
    pinMode(this->pin_droite, OUTPUT);
    pinMode(this->pin_gauche, OUTPUT);
    pinMode(this->speed_droite, OUTPUT);
    pinMode(this->speed_gauche, OUTPUT);
    digitalWrite(this->pin_droite, this->avant);
    digitalWrite(this->pin_gauche, this->avant);
  };

  void action(int commande){
     this->robot->set_commande(commande);
     if (commande == AVANCE) this->avance();
     else if (commande == RECULE) this->recule();
     else if (commande == DROITE) this->droite();
     else if (commande == GAUCHE) this->gauche();
     else if (commande == STOP) this->stop();
     else if (commande == LENT) this->lent();
     else if (commande == RAPIDE) this->rapide();
  };

  void init(int vitesse_droite, int vitesse_gauche){
      this->stop();
      this->robot->set_commande(AVANCE);
      digitalWrite(this->pin_droite, this->avant);
      digitalWrite(this->pin_gauche, this->avant);
      analogWrite(this->speed_droite, vitesse_droite);
      analogWrite(this->speed_gauche, vitesse_gauche);
  };

  void bip(void)  { // test moteur
      digitalWrite(this->pin_droite, this->avant);
      digitalWrite(this->pin_gauche, this->avant);
      analogWrite(this->speed_droite, this->vitesse_min);
      analogWrite(this->speed_gauche, this->vitesse_min);
      delay(100);
      analogWrite(this->speed_droite, 0);
      analogWrite(this->speed_gauche, 0);
      delay(400);
  };

  void lent(){
  }

  void rapide(){
  }

  void stop(void)  {
      this->robot->set_commande(STOP);
      analogWrite(this->speed_droite, 0);
      analogWrite(this->speed_gauche, 0);
  };

  void avance()  {
      this->robot->set_commande(AVANCE);
      analogWrite(this->speed_droite, this->vitesse_max);
      analogWrite(this->speed_gauche, this->vitesse_max);
      digitalWrite(this->pin_droite, this->avant);
      digitalWrite(this->pin_gauche, this->avant);
  };

  void droite()  {
      this->robot->set_commande(DROITE);
      analogWrite(this->speed_droite, this->vitesse_max);
      analogWrite(this->speed_gauche, this->vitesse_max);
      digitalWrite(this->pin_droite, this->avant);
      digitalWrite(this->pin_gauche, this->arriere);
  };

  void gauche()  {
      this->robot->set_commande(GAUCHE);
      analogWrite(this->speed_droite, this->vitesse_max);
      analogWrite(this->speed_gauche, this->vitesse_max);
      digitalWrite(this->pin_droite, this->arriere);
      digitalWrite(this->pin_gauche, this->avant);
  };

  void recule()  {
      this->robot->set_commande(RECULE);
      analogWrite(this->speed_droite, this->vitesse_max);
      analogWrite(this->speed_gauche, this->vitesse_max);
      digitalWrite(this->pin_droite, this->arriere);
      digitalWrite(this->pin_gauche, this->arriere);
  };

};
//-------------------- ULTRASON  -------------------------------

class Ultrason{
  private:
#define SOUND_SPEED 0.034
    const int trigger = D6;
    const int echo = D7;
    //define sound speed in cm/uS
    const int seuil1 = 40;  // si on est > seuil1 on avance, si non on tourne à droite
    const int seuil2 = 10;  // si on est < seuil2 on stop car on n'a plus la place de tourner
    Motorisation* motor = NULL;

  public:
     const int max = 40;  // si on est > seuil1 on avance, si non on tourne à droite
    const int min = 10;  // si on est < seuil2 on stop car on n'a plus la place de tourner
    Ultrason(Motorisation* motor){
    pinMode(this->trigger, OUTPUT); // Sets the trigger as an Output
    pinMode(this->echo, INPUT); // Sets the echo as an Input
    this->motor = motor;
  };

  int read(){
     long duration;
     digitalWrite(this->trigger, LOW);
      delayMicroseconds(2);
     // Sets the trigger on HIGH state for 10 micro seconds
     digitalWrite(this->trigger, HIGH);
     delayMicroseconds(10);
     digitalWrite(this->trigger, LOW);
     // Reads the echo, returns the sound wave travel time in microseconds
     duration = pulseIn(this->echo, HIGH);

     //   Serial.println(duration * SOUND_SPEED/2);
     if ((duration < 60000) && (duration > 1)) {
        // Calcule la distance quand la lecture est vraisemblable
        return (duration * SOUND_SPEED/2);
    } else {
        return (0);
    };
  };

  int action(){
    int obstacle = this->read();
    if (obstacle == 0) {}
    else if (obstacle < this->seuil2) {
      // on n'a plus la place de tourner
      this->motor->stop();
      return (STOP);
    }
    else if (obstacle < this->seuil1) {
      // on contourne l'obstacle
      this->motor->droite();
    }
    else {
      // pas d'obstacle on avance
      this->motor->avance();
    };
    return (AVANCE);
  };
};
//-------------------- OPTIQUE -------------------------------
class Optique{
private:
    Robot* robot = NULL;
    Motorisation* motor = NULL;
    int capteur = A0;         // lecture              DEFINIR LES VRAIES VALEURS DES PINS ASSOCIEES
    int balance_faite = 0;

public:
    int sensibilite = 50;     // seuil de sensibilite droite/gauche
    long balance = 1024/2;

   Optique(Robot* robot, Motorisation* motor){
       this->robot = robot;
       this->motor = motor;
   };

   long lecture(){
       return (analogRead(this->capteur));
   };

   void balance_des_blancs(){
       if (this->balance_faite) return;
       // positionner une feuille blanche très près du capteur optique
       long valeur = this->lecture();
       this->balance = valeur;
       this->balance_faite = 1;
   };

   long delta(){
      // mesure la différence entre le capteur de droite et le capteur de gauche
      // si le capteur de droite est > au capteur de gauche => delta > 0

       long valeur = this->lecture() - this->balance;

       return (valeur);
   };

   void action(){
       int vitesse;
       int dir = 0;

       this->motor->stop();

       int delta = this->delta();
       this->motor->avance();

       if (abs(delta) < this->sensibilite)  {
          // pas de différence notable
          if (this->robot->dir != AVANCE) {
             // on remet le robot en marche avant
             // Serial.println(delta);
             // Serial.println("tout droit");
             this->robot->set_commande(AVANCE);
          }

          if (delta > 0 ) {
             // optique droite + => il faut redresser vers la droite
             // on freine sur la roue droite donc on tourne à droit
             // on calcule la vitesse à appliquer proportinnelle au delta
             // vitesse = map(delta, 0, this->sensibilite, 0, this->motor->vitesse_max);
             // this->motor->init(vitesse, this->motor->vitesse_max);
             this->motor->init(this->motor->vitesse_min, this->motor->vitesse_min);
          } else if (delta < 0) {
             // optique gauche + => il faut redresser vers la gauche
             // on freine sur la roue gauche donc on tourne à gauche
             // on calcule la vitesse à appliquer proportinnelle au delta
             vitesse = map(-delta, 0, this->sensibilite, 0, this->motor->vitesse_max);
             // this->motor->init(this->motor->vitesse_max, vitesse);
             this->motor->init(this->motor->vitesse_min, this->motor->vitesse_min);
          }
       } else {
          // delta important: on le renormalise
          delta = delta / 2;
          if (delta > this->sensibilite) delta = this->sensibilite;
          else if (delta < -this->sensibilite) delta = -this->sensibilite;

          if (delta > 0) {
             // optique droite + => il faut redresser vers la droite
             // on freine sur la roue gauche donc on tourne à gauche
             // on calcule la vitesse à appliquer proportinnelle au delta
             vitesse = map(delta, 0, this->sensibilite, 0, this->motor->vitesse_max);
             this->motor->droite();
             //this->motor->init(this->motor->vitesse_max, vitesse);
             this->motor->init(this->motor->vitesse_min, this->motor->vitesse_min);
          } else if (delta < 0) {
             // optique gauche + => il faut redresser vers la gauche
             // on freine sur la roue droite donc on tourne à droit
             // on calcule la vitesse à appliquer proportinnelle au delta
             vitesse = map(-delta, 0, this->sensibilite, 0, this->motor->vitesse_max);
             this->motor->gauche();
             // this->motor->init(vitesse, this->motor->vitesse_max);
             this->motor->init(this->motor->vitesse_min, this->motor->vitesse_min);
          }
       }
    }
};
//-------------------- COYOTE -------------------------------
class Coyote{
public:
   boolean flag;
   void init(){
//      pinMode(D7, OUTPUT);
   }
   int blink(){
    flag = !flag;
//    digitalWrite(D7, flag);
   };
};
Web web;
Robot robot;
Motorisation M(&robot);
Ultrason U(&M);
Optique O(&robot, &M);
Coyote C;

int Mode = MANUEL;
// int Mode = COLLISION; // initialisation

//------------------NEO --------------
// Input a value 0 to 255 to get a color value.
// The colours are a transition r - g - b
uint32_t Wheel(byte WheelPos) {
  WheelPos = 255 - WheelPos;
  if(WheelPos < 128) {
    return pixels.Color(WheelPos * 2,255 - WheelPos * 2,0 );
  }
    WheelPos -= 128;
    return pixels.Color(255 - WheelPos * 2,  0,WheelPos * 2 );
};
void neo(int color){ 
  if (color <0 ) color=0;
  if (color > 255) color= 255;
  pixels.setPixelColor(0,Wheel(color)); 
    pixels.show();   // Send the updated pixel colors to the hardware.
}
#define NB_COLOR 4 // nombre de couleurs pour la distance
void neo_distance(int color){ 
  if (color <0 ) color=0;
  if (color > NB_COLOR) color= NB_COLOR;
  switch(color){
        case 0 :// rouge
          pixels.setPixelColor(0, pixels.Color(0, 150, 0)); break;
        case 1 ://jaune
          pixels.setPixelColor(0, pixels.Color(150, 250, 0)); break;
        case 2 :// blanc
        pixels.setPixelColor(0, pixels.Color(150, 150, 150)); break;
        case 3 :// bleu
          pixels.setPixelColor(0, pixels.Color(0, 0, 150)); break;
       case 4 ://vert
          pixels.setPixelColor(0, pixels.Color(150, 0, 0)); break;
  }
    pixels.show();   // Send the updated pixel colors to the hardware.
}
/* ------------------AUTO-TEST ----------------

1 bip : moteur
2 bip : capteur optique branché
3 bip : capteur optique à l'équilibre

si la distance ultrason est inférieure à seuil2 : passage en manuel

*/
void auto_test(){
    unsigned long currentMillis = millis();
    int flag=1; // 
    
    if (O.lecture() > 10) M.bip();
    if (abs(O.lecture() - 512) < 100 ) {
       M.bip();
       O.balance_des_blancs();
       Serial.print("Balance des blancs");
       Serial.println(O.balance);
    }
     while(O.lecture() > 10) { // capteur optique présent
            int delta;
            Serial.print("delta :");
            Serial.print(delta=O.delta());
            neo( delta + 128);// vert au centre
            if (abs(delta) < 50)  {
                    if ( (millis()- currentMillis)< 2000 ) M.avance(); else M.stop();
                } else {
              currentMillis = millis();
              if (delta > 0 ) {
             // lumière à droite => il faut redresser vers la droite
                            M.droite();

              } else if (delta < 0) {
             // lumière à gauche => il faut redresser vers la gauche
                            M.gauche();
            }
           }
           
     }
     // 
          int retour = U.action();
  //        Serial.println(U.read());
          Mode = retour;
          if (retour == STOP) {
              Mode = MANUEL;
              flag=0;
          } else if (retour == AVANCE) {
     
              Serial.print(" distance :");
              int u;
              Serial.println(u = U.read());    
              neo ( (NB_COLOR * ( u - U.min)) / (U.max - U.min));
              delay(200);

          } else {
              U.action();
          }
     }

void setup()
{
   Serial.begin(115200);
   Serial.println("ROBOT");
       M.bip();

    int i=5;
    while(i--){ // AUTOTEST des 5 couleurs
        neo_distance(i);
    delay(500);
    }
    while( int u = U.read() > 10 ){ // AUTOTEST ultrason avec 5 couleurs
          // Serial.println(u = U.read());    
              neo_distance ( (NB_COLOR * ( u - U.min)) / (U.max - U.min));
              delay(200);
      
    }
              

   auto_test();
      web.init(&robot);
}

void loop()
{
     auto_test(); // AUTOTEST ultrason + moteur + solaire

}
