anumby-source/RobotServiceJeunesse2022/(commit log)

2022-03-08 document de def du projet précédent
2022-03-09 Import des documents de la version 2019 (Philippe)
2022-03-09 Déplacement des fichiers de la version 2019 dans un dossier 2019
2022-03-09 Documents administratifs pour le 6 mai
    [2022 03 09 Devis animation service jeunesse V1.xlsx]
2022-03-09 ajout de .gitignore
2022-03-10 Mise en place de l'infrasructure pour les grands composants
2022-03-15 on complète la nomenclatue
    [Nomen_Véhi.ods]
2022-03-15 prêt à valider
    [Nomen_Véhi.ods]
2022-03-22 descriptif des pièces détachées du proto 2019
2022-03-23 typo dans les noms
2022-03-23 Amélioration esthétique du clode de voiture.ino
2022-03-23 Amélioration esthétique du clode de voiture_eclairee.ino
2022-03-23 Début de la conversion de voiture.ino en voiture.py. Conversion purement textuelle pour l'instant. Pas de fonctionnalité
2022-03-23 Amélioration esthétique du clode de voiture.ino Add docs to README.md continue conversion (still need server conversion)
2022-04-04 Ajout de schémas
    [robot.kicad_pcb, robot.sch]
2022-04-20 Ajout de plusieurs essais de code Ajout du tuto de Pierre
2022-04-21 Version 0 du code robot avec la fonctionnalité de base Web mode manuel Brêt à être uploadé
2022-04-21 Utiliser l'adresse fixe 44.44.44.44 puisqu'on différencie les connexions par le Wifi-id
    [robot.ino]
2022-04-24 Programme de test pour ultrason robot/ultrason Intégration de ultrason dans le pgm général robot Développement du pgm de simulation du robot: pour l'instant ultrason
2022-04-24 Simulation du robot: fix problem in global rotation of the robot by using a complex representation of points + rotation by complex notation
    [simulation.py]
2022-04-25 Simulation du robot: remplacement complet de la classe Point par complex natif du Python => fiabilisation des algos !!!
2022-04-25 Simulation du robot: implémentation minimale du mode COLLISION pour Arduino seuil1 on a détecté un obstacle => on tourne à droite seuil2 trop près de l'obstacle, on n'a plus la place de tourner on st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
    [robot.ino]
2022-04-26 ajout d'un test dans README.md de code
2022-04-27 Mise à jour du code unitaire ultrason avec les bonnes PIN D6/D7 = 12/13 Simulation finalisation du mode OPTIQUE
2022-04-27 Ajout d'une entête pour le code Arduino du Robot
2022-04-28 Première implémentation du mode SUIVI dans le code Arduino du Robot il demande vérification !!!
2022-04-29 Code robot.ino - corrections de Arnaud: - branchements pour les capteurs optiques - auto-test
    [robot.ino]
2022-04-29 Code robot.ino - corrections de Arnaud: - branchements pour les capteurs optiques - auto-test - Ajout de la balance des blancs - nouvelle commande sur l'interface web - initialiser manuellement la ba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
    Tutoriel pour le montage du robot
    [robot.ino]
2022-04-29 Robot.ino: utilise vitesse_min lors du test bip fix
    [robot.ino]
2022-04-29 Robot.ino: utiliseajoute un print pour la balance des blancs
2022-04-30 Robot.ino: Améliorations de l'interface web READMEmd pour le code robot
2022-04-30 Robot.ino: Changement de la logique pour les rotations: - quand on commande une rotation on avance uniquement une roue (l'autre est à l'arrêt) - dès qu'on a effectué une rotation d'un petit angle, on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
2022-04-30 Robot.ino: Simplification de l'algo pour le Capt.Photo.Sens.
2022-05-01 Robot.ino: Quelques nettoyages - gestion de la vitesse en pourcentage [0..100] (et gestion finale pour le hard en PWM [0..255]) - ralentissement de la boucle loop pour laisser le temps de l'interface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
2022-05-01 Robot.ino: Optimiser la production de la page HTML en utilisant client.write à la place de client.print => implémentation de la commande pour controler la vitesse
2022-05-02 Robot.ino: Remise en place de saisie manuelle du ssid
2022-05-02 Robot.ino: Intégration de la dernière de l'autotest de Arnaud
2022-05-03 modif pour robot.ino: - retour au ssid constructeur - installation de l'autotest dernière version (coyotte)
2022-05-05 Réécriture du code robot pour intégrer la librairie client-serveur utilisée dans le code d'origine (2019) Recomposition de l'interface Web en plusieurs écrans spécialisés
2022-05-05 ajout de différents essais code ancien de 2019
2022-05-10 mise à jour après le stage
    [reste à faire RSJ22 au lendemain de l'atelier avec enfants.xls]
2022-05-13 robot.ino: Beaucoup d'améiorations dans le code: - fiabilisation de la motorisation (calibration des 3 vitesses) - mise en place du mode collision avec marche arrière quand on est au contact d'un obs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
    [motorisation.ino, robot.ino, ultrason.ino]
2022-05-15 robot.ino - renommer "balance" en "equilibrage" - leecture moyennée de l'ultrason pour lisser les glitches
    [robot.ino]
2022-05-16 robot.ino: mention de la carte utilisée pour la compilation
